DanielAraqueStudios/Fluids-Mechanics-RC-Ship/informe/ACTUALIZACION_LATEX.md

# Actualización del Informe LaTeX - Geometría Híbrida Piramidal

**Fecha:** 2025-11-20  
**Archivo:** `informe_barcaza.tex`  
**Estado:** ✅ ACTUALIZADO CON PARÁMETROS REALES

---

## Cambios Principales Implementados

### 1. **Geometría del Casco Corregida**

#### ANTES (incorrecto):
- Casco tipo barcaza rectangular simple
- Dimensiones genéricas (L=0.45m, B=0.20m, H=0.08m)
- Sin distinción entre proa y popa

#### AHORA (correcto):
- **Casco híbrido pyramid-rectangular**
- **Proa piramidal:** 5 cm con vértice A en cubierta
- **Popa rectangular:** 40 cm con sección constante 17.2×15.6 cm
- **Vista superior:** Pentagonal (triángulo + rectángulo)
- **Dimensiones reales:**
  - Eslora total: 0.45 m
  - Manga: 0.172 m
  - Puntal: 0.156 m
  - L_proa: 0.05 m
  - L_popa: 0.40 m

---

### 2. **Cálculos de Volumen Actualizados**

#### Fórmulas implementadas:

**Proa (pirámide):**
```
∇_proa = (1/3) × (B × T) × L_proa
∇_proa = (1/3) × (0.172 × 0.055) × 0.05 = 1.58×10⁻⁴ m³
```

**Popa (prisma rectangular):**
```
∇_popa = L_popa × B × T
∇_popa = 0.40 × 0.172 × 0.055 = 0.003784 m³
```

**Total:**
```
∇ = ∇_proa + ∇_popa = 0.003942 m³
Δ = ρ × ∇ = 3.942 kg
```

---

### 3. **Análisis de Flotación Agregado**

Nueva sección con verificación de equilibrio:

```latex
Fuerza de flotabilidad: Fb = Δ × g = 38.668 N ↑
Fuerza peso total:      W = m_total × g = 46.107 N ↓
Fuerza neta:            F_neta = -7.439 N

Estado: ✗ SE HUNDE con 4.70 kg (requiere T=6.56cm)
```

**Conclusión crítica:** Para cumplir T < 6cm, masa máxima = 4.30 kg  
(Actual: 4.70 kg → requiere reducción de 0.40 kg)

---

### 4. **Centro de Flotabilidad (KB) Corregido**

#### Método anterior (incorrecto):
```
KB ≈ 0.5 × T = 0.0275 m
```

#### Método actual (correcto):
```
KB = (∇_proa × z_proa + ∇_popa × z_popa) / ∇
   = (1.58×10⁻⁴ × 0.01375 + 0.003784 × 0.0275) / 0.003942
   = 0.0269 m = 2.69 cm
```

Nota: Centroide de pirámide a 1/4 altura (no 1/3 como triángulo).

---

### 5. **Parámetros de Estabilidad Actualizados**

| Parámetro | Valor Calculado | Criterio | Estado |
|---|---|---|---|
| KB | 2.69 cm | - | ✓ |
| BM | 4.32 cm | - | ✓ |
| KG | 4.85 cm | Bajo | ✓ |
| **GM** | **2.16 cm** | **> 5 cm** | **⚠ MARGINAL** |
| Calado @ 2.5kg | 6.0 cm | < 6 cm | ✓ Límite |
| Calado @ 4.7kg | 6.56 cm | < 6 cm | ✗ Excede |

**Implicaciones:**
- Estabilidad marginal (GM < 5cm)
- Sensible a cargas asimétricas: 1kg @ 2cm → 13.2° escora
- Requiere distribución cuidadosa de carga en línea central

---

### 6. **Resistencia y Potencia Actualizadas**

#### Parámetros corregidos:
- Área mojada: S = 0.165 m² (geometría híbrida)
- Factor de forma: k = 0.2 (transiciones suaves)
- Número de Reynolds: Re = 2.24×10⁵
- Número de Froude: Fr = 0.238 (modo desplazamiento)

#### Resultados:
```
Rf = 0.110 N (fricción ITTC-1957)
Rv = 0.132 N (viscosa con k=0.2)
RT = 0.165 N (total con olas + aire)

PE = RT × V = 0.083 W
P_eje = PE / η_T = 0.218 W (η_T = 0.38)
```

**Margen de potencia:** 0.218 W << 75 W límite (99.7% de reserva)

---

### 7. **Distribución de Masas Real**

| Componente | Masa (kg) | Altura CG (cm) |
|---|---|---|
| Casco MDF 4mm + pintura | 1.20 | 4.0 |
| Electrónica (ESP32, L298N, motores) | 1.00 | 3.0 |
| Batería 12V | 0.35 | 3.0 |
| Carga útil | 2.50 | 6.0 |
| **TOTAL** | **4.70 kg** | **KG = 4.85 cm** |

---

### 8. **Herramientas de Simulación Documentadas**

Nueva subsección agregada:

```bash
# Scripts Python desarrollados:
- stability_analysis.py     → GM, KB, BM, flotación
- resistance_calc.py        → ITTC-1957, curvas R(V)
- visualize_hull_3d.py      → Geometría 3D híbrida
- run_all_analysis.py       → Suite automatizada

# Uso:
python run_all_analysis.py --cargo 2.5 --velocity 0.5

# Salidas:
- hull_3d_*.png            → Visualización del casco
- stability_*.png          → Gráficas de estabilidad
- resistance_*.png         → Curvas de resistencia
- analysis_report_*.txt    → Reporte completo
```

---

### 9. **Conclusiones Actualizadas**

Se modificaron 9 puntos de conclusiones para reflejar:

1. ✅ Geometría híbrida pyramid-rectangular implementada
2. ✅ Método ITTC-1957 aplicado a geometría no convencional
3. ✅ Sistema ESP-NOW con latencia 10-17ms
4. ⚠ Potencia 0.22W << 75W (sobrado)
5. ✅ Factor de forma k=0.2 apropiado (optimizable a 0.15)
6. ⚠ GM=2.16cm estable pero marginal (sensible a carga asimétrica)
7. ✅ Geometría piramidal reduce resistencia por olas
8. ✅ Interfaz PyQt6 para control y telemetría
9. ✅ Validación de métodos de arquitectura naval a escala

---

### 10. **Recomendaciones Expandidas**

12 recomendaciones específicas agregadas:

1. **Reducir masa a 4.30kg** (cumplir T<6cm)
2. **Aumentar GM a >5cm** (mejorar estabilidad)
3. **Guías de carga** (evitar escoras excesivas)
4. **Validación experimental** (medir calado real)
5. **Sensor INA219** (potencia/IT en tiempo real)
6. **Optimizar k a 0.15** (pulir superficie)
7. **IMU MPU6050** (medir escora real)
8. **GPS** (tracking, IT automático)
9. **LoRa SX1276** (alcance 1-2km)
10. **Banco de pruebas** (optimizar hélices)
11. **Data logger microSD** (telemetría local)
12. **Análisis paramétrico** (variantes con Python)

---

## Valores Críticos para Referencia Rápida

### Dimensiones
```
L = 0.45 m (5cm proa + 40cm popa)
B = 0.172 m
H = 0.156 m
T_objetivo = 0.055 m (@ 4.70 kg excede límite)
T_límite = 0.060 m (cumple con 4.30 kg máx)
```

### Estabilidad
```
GM = 2.16 cm ⚠
KB = 2.69 cm
BM = 4.32 cm
KG = 4.85 cm
```

### Flotación
```
Δ @ T=5.5cm = 3.942 kg
m_total = 4.70 kg
Fb = 38.67 N ↑
W = 46.11 N ↓
Déficit = 7.44 N → SE HUNDE
```

### Hidrodinámica
```
Re = 2.24×10⁵
Fr = 0.238
RT = 0.165 N @ 0.5 m/s
PE = 0.083 W
P_eje = 0.218 W (<<< 75W)
```

---

## Estado del Informe

✅ **Geometría:** Actualizada (pirámide + rectangular)  
✅ **Volúmenes:** Fórmulas correctas implementadas  
✅ **Estabilidad:** KB, BM, GM calculados correctamente  
✅ **Flotación:** Sección agregada con análisis completo  
✅ **Resistencia:** Actualizada con área mojada real  
✅ **Potencia:** Recalculada con eficiencias realistas  
✅ **Masas:** BOM con valores reales  
✅ **Herramientas:** Sección de Python agregada  
✅ **Conclusiones:** 9 puntos actualizados  
✅ **Recomendaciones:** 12 recomendaciones específicas  

---

## Próximos Pasos Sugeridos

1. **Compilar LaTeX** para verificar errores de sintaxis
2. **Revisar figuras:** Agregar imágenes generadas por Python scripts
3. **Validar referencias cruzadas** (ecuaciones, tablas, figuras)
4. **Generar PDF final** y verificar formato IEEE
5. **Realizar pruebas experimentales** para validar cálculos teóricos
6. **Actualizar resultados** con datos experimentales cuando estén disponibles

---

**Archivo generado automáticamente por GitHub Copilot**  
**Basado en análisis de:** `analysis_report_20251120_155618.txt`
