DanielAraqueStudios/Fluids-Mechanics-RC-Ship/simulations/requirements_gui.txt

# RC Cargo Barge Analysis - GUI Requirements
# Professional Dark Mode Dashboard

# Core GUI Framework
PyQt6>=6.6.0
PyQt6-Qt6>=6.6.0

# Plotting and Visualization
matplotlib>=3.8.0
numpy>=1.24.0

# Data handling
scipy>=1.11.0

# Optional for enhanced features
pillow>=10.0.0
