DanielAraqueStudios/Fluids-Mechanics-RC-Ship/simulations/analysis_results/analysis_report_20251120_214805.txt

==========================================================================================
                      RC CARGO BARGE - COMPREHENSIVE ANALYSIS REPORT                      
==========================================================================================

Generated: 2025-11-20 21:48:38

                                  DESIGN SPECIFICATIONS                                   
------------------------------------------------------------------------------------------
  Total Length:              45.0 cm
  Beam:                      17.2 cm
  Height:                    15.6 cm
  Bow section:               5.0 cm (pyramidal)
  Stern section:             40.0 cm (rectangular)
  Material:                  MDF 4mm + waterproofing paint

                                    MASS DISTRIBUTION                                     
------------------------------------------------------------------------------------------
  Hull (MDF + paint):        1.20 kg
  Electronics (ESP32+motor): 0.80 kg
  Cargo:                     2.50 kg
  TOTAL:                     4.50 kg

                                  CALCULATED PARAMETERS                                   
------------------------------------------------------------------------------------------
  Required draft:            6.28 cm
  Draft margin (< 6 cm):     -0.28 cm ✗ EXCEDE
  Displaced volume:          4500.0 cm³
  Displacement:              4.50 kg
  Buoyancy force:            44.14 N
  Weight force:              44.15 N

                                     ANALYSIS RESULTS                                     
------------------------------------------------------------------------------------------
  3D Hull Visualization                                                   ✓ SUCCESS
  Stability Analysis                                                      ✓ SUCCESS
  Resistance Calculation                                                  ✓ SUCCESS

==========================================================================================
                                       OUTPUT FILES                                       
==========================================================================================
  3D Hull:      analysis_results\hull_3d_20251120_214805.png
  Stability:    analysis_results\stability_20251120_214805.png
  Resistance:   analysis_results\resistance_20251120_214805.png
  This report:  analysis_results\analysis_report_20251120_214805.txt

==========================================================================================

                                  DESIGN RECOMMENDATIONS                                  
==========================================================================================
  ⚠ Draft exceeds 6 cm limit
     → Maximum total mass for T<6cm: 4.30 kg
     → Current total mass: 4.50 kg
     → Reduce mass by: 0.20 kg

  Stability improvements:
    • Increase beam width for higher GM
    • Lower center of gravity (add ballast at keel)
    • Reduce top-heavy loads
    • Test with actual load distribution

  Performance optimization:
    • Smooth hull surface (reduce form factor k)
    • Optimize propeller efficiency
    • Minimize wetted surface area
    • Test at different velocities for optimal IT
