DanielAraqueStudios/Fluids-Mechanics-RC-Ship/hull_3d_real.png

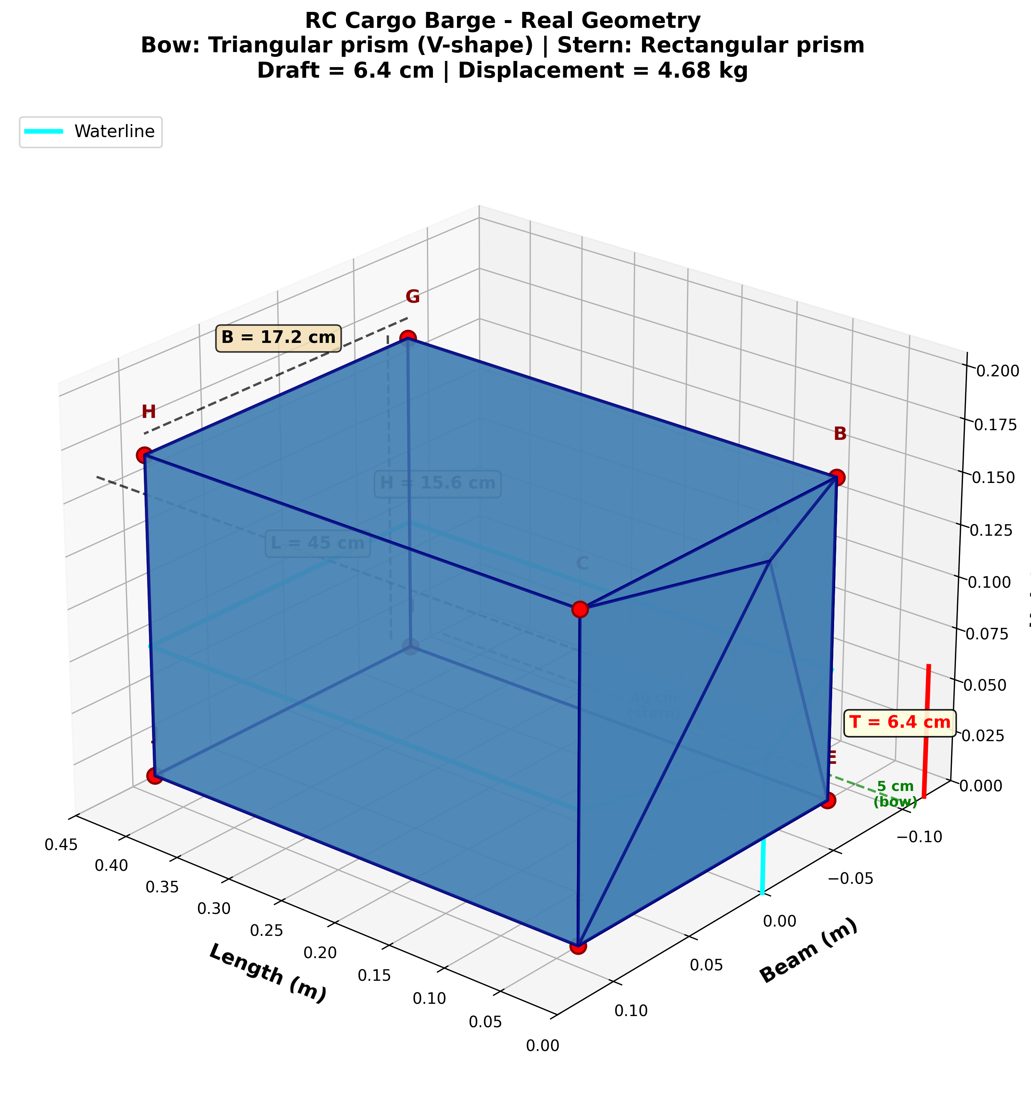
hull_3d_real.png
