DanielAraqueStudios/Fluids-Mechanics-RC-Ship/hull_draft_curves.png

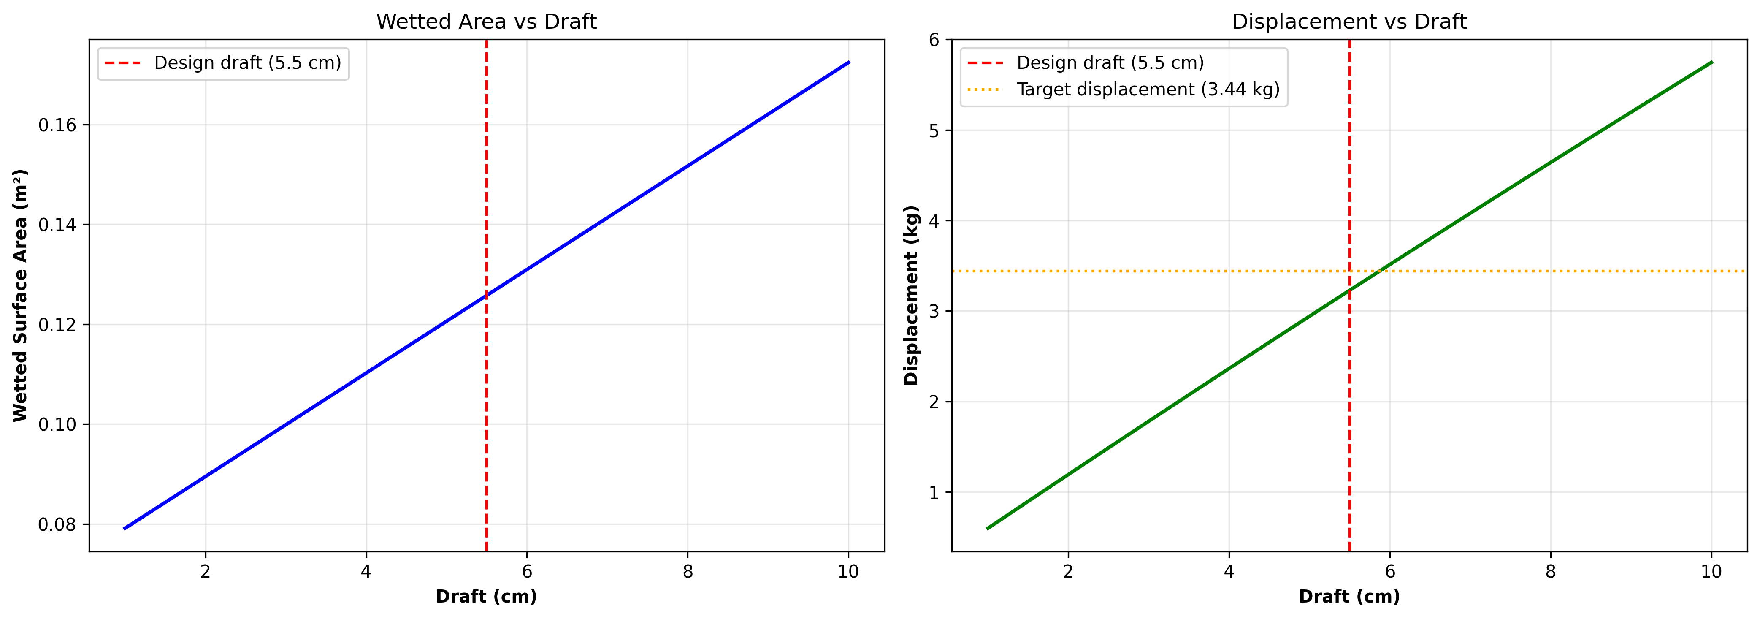
hull_draft_curves.png
