DanielAraqueStudios/Fluids-Mechanics-RC-Ship/hull_geometry_3d.png

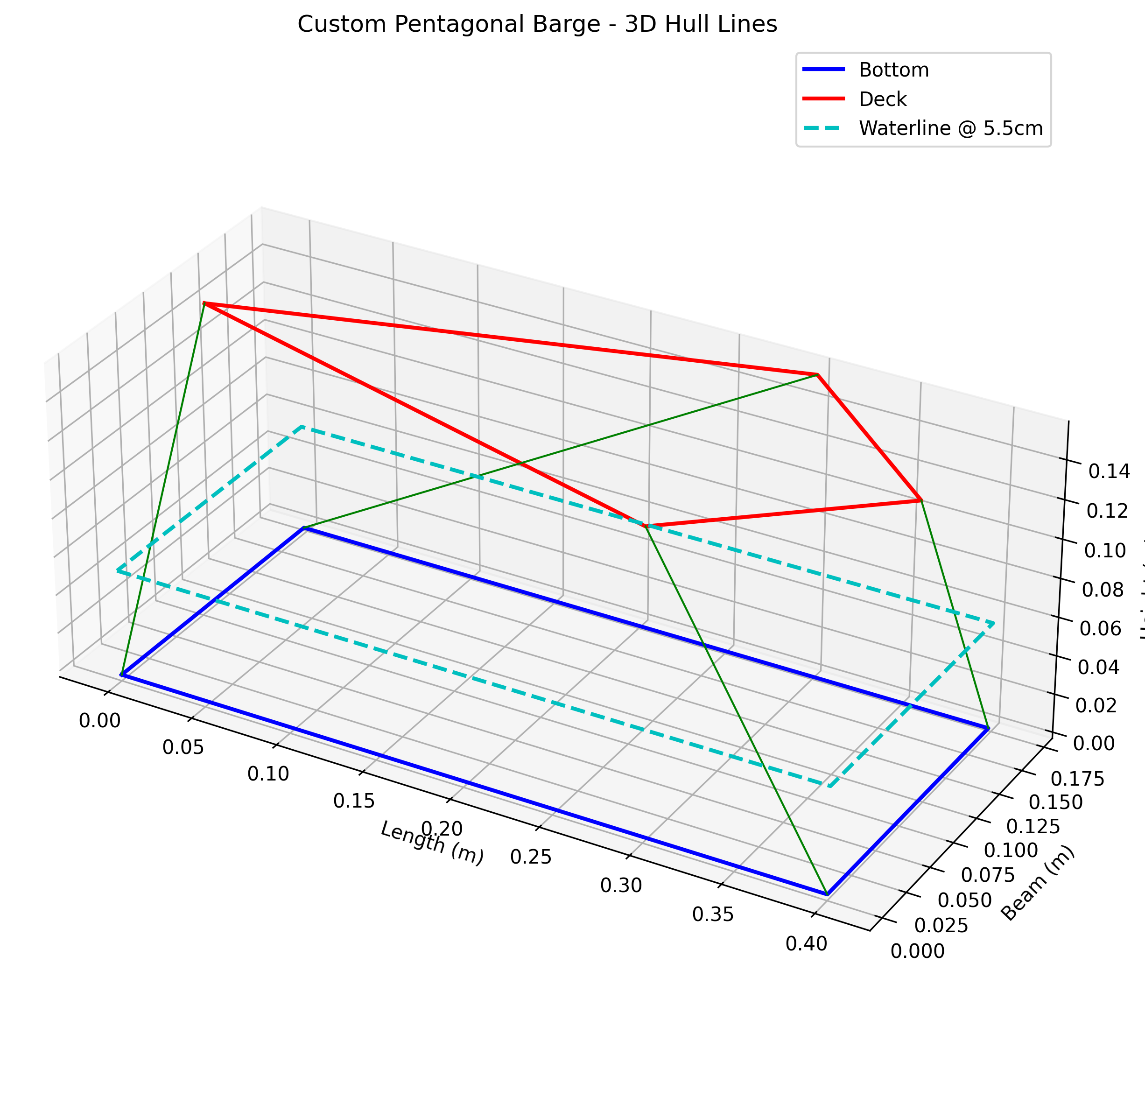
hull_geometry_3d.png
