DanielAraqueStudios/Fluids-Mechanics-RC-Ship/tests/stability_test_data.csv

timestamp | test_number | cargo_mass_kg | total_mass_kg | draft_measured_cm | heel_angle_deg | notes
2025-11-18 09:15:23 | 1 | 0.0 | 2.25 | 2.9 | 0.5 | Empty hull - baseline
2025-11-18 09:22:45 | 2 | 0.5 | 2.75 | 3.6 | 1.2 | Added 500g cargo centered
2025-11-18 09:28:12 | 3 | 1.0 | 3.25 | 4.3 | 1.8 | 1kg cargo - slight list to port
2025-11-18 09:35:08 | 4 | 1.5 | 3.75 | 4.9 | 2.3 | 1.5kg cargo - stable
2025-11-18 09:42:56 | 5 | 2.0 | 4.25 | 5.6 | 3.1 | 2kg cargo - noticeable draft increase
2025-11-18 09:51:33 | 6 | 2.5 | 4.75 | 6.2 | 4.7 | 2.5kg cargo - near design limit
2025-11-18 10:02:18 | 7 | 2.8 | 5.05 | 6.5 | 7.8 | 2.8kg cargo - exceeds 6cm draft limit
2025-11-18 10:08:45 | 8 | 2.5 | 4.75 | 6.1 | 2.1 | Repositioned 2.5kg cargo - improved stability
2025-11-18 10:15:22 | 9 | 2.5 | 4.75 | 6.0 | 1.9 | Final configuration - cargo optimized
