DanielAraqueStudios/Fluids-Mechanics-RC-Ship/tests/velocity_power_sweep.csv

timestamp | test_velocity_ms | measured_time_s | distance_m | avg_voltage_V | avg_current_A | avg_power_W | cargo_kg | water_temp_C | notes
2025-11-19 15:20:34 | 0.30 | 66.8 | 20 | 11.94 | 0.028 | 0.334 | 2.5 | 19.2 | Slow speed test
2025-11-19 15:28:17 | 0.40 | 50.5 | 20 | 11.91 | 0.035 | 0.417 | 2.5 | 19.3 | Medium speed
2025-11-19 15:35:42 | 0.50 | 46.2 | 20 | 11.86 | 0.038 | 0.451 | 2.5 | 19.4 | Design speed
2025-11-19 15:42:08 | 0.60 | 38.7 | 20 | 11.81 | 0.052 | 0.614 | 2.5 | 19.5 | High speed
2025-11-19 15:48:55 | 0.70 | 32.3 | 20 | 11.75 | 0.068 | 0.799 | 2.5 | 19.7 | Near max speed
2025-11-19 15:30:12 | 0.50 | 48.9 | 20 | 11.88 | 0.037 | 0.440 | 2.0 | 19.3 | Reduced cargo 2kg
2025-11-19 15:38:45 | 0.50 | 51.2 | 20 | 11.84 | 0.041 | 0.485 | 3.0 | 19.5 | Increased cargo 3kg - struggled
