DanielAraqueStudios/Fluids-Mechanics-RC-Ship/simulations/analysis_results/resistance_20251120_214805.png

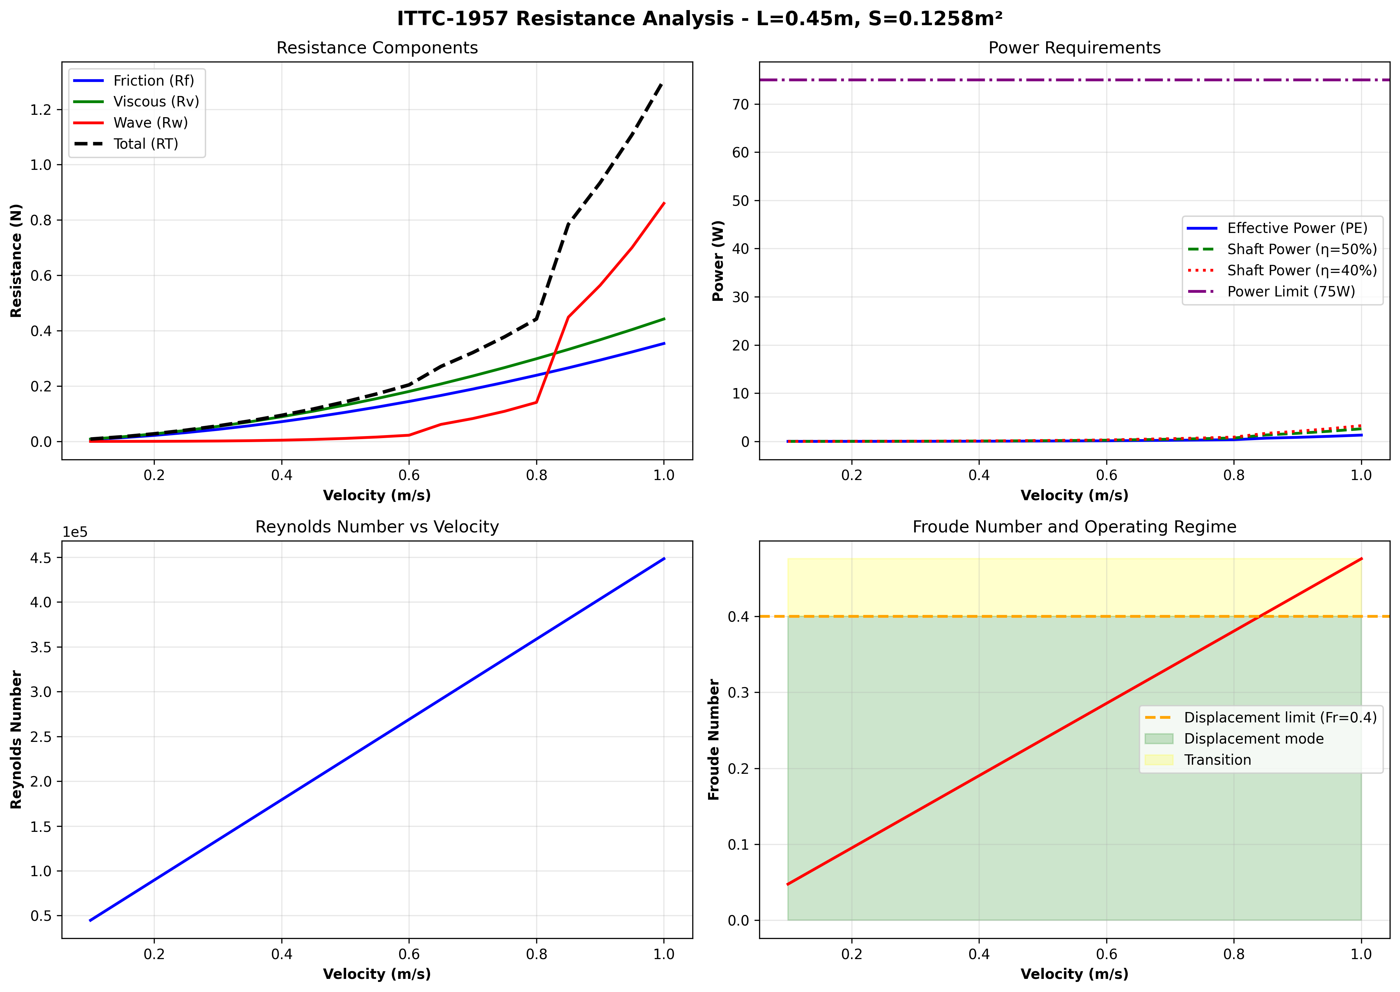
simulations/analysis_results/resistance_20251120_214805.png
