DanielAraqueStudios/Fluids-Mechanics-RC-Ship/(commit log)

2025-11-19 feat: Sistema completo RC barca con control PWM
    - Implementar control PWM (0-255) en ESP32 para velocidad variable
    - Crear interfaz gráfica profesional con PyQt6 (dark theme)
    - Generar informe técnico LaTeX formato IEEE
    - Modificar EspBarco.ino para recibir y aplicar velocidad PWM
    - Modificar EspControl.ino para enviar comandos con velocidad
    - Documentación completa: README_GUI, INICIO_RAPIDO
    - Resolver estructura git (convertir submodule a directorio normal)
    [EspBarco.ino, EspControl.ino, boat_control_gui.py]
2025-11-20 feat: Estructura completa del proyecto con simulaciones y documentación
    - Agregar scripts Python ITTC-1957 (resistance_calc.py, stability_analysis.py)
    - Crear directorios: cad/, plans/, simulations/, tests/
    - README.md principal con documentación completa
    - Templates para pruebas experimentales (test_template.csv)
    - Guías de construcción y análisis en cada directorio
    - Copilot instructions actualizadas
    - Listo para fase de construcción y testing
    [test_template.csv]
2025-11-21 iamges latex update
    [esp_now_latency_test.csv, navigation_test_20m.csv, stability_test_data.csv, velocity_power_sweep.csv]
