DanielAraqueStudios/Fluids-Mechanics-RC-Ship/(notices)

Notices in the files:
README.md:
License: MIT
